wangyeee/paparazzi-hardware/controller/lisa_lc/v1.1/prod/readme.txt

Note:
Only the gerber files are tested. The pick & place files are not. Use at your own risk.
