wangyeee/paparazzi-hardware/controller/lisa_lc/v1.1/IMU.pdf

A

A

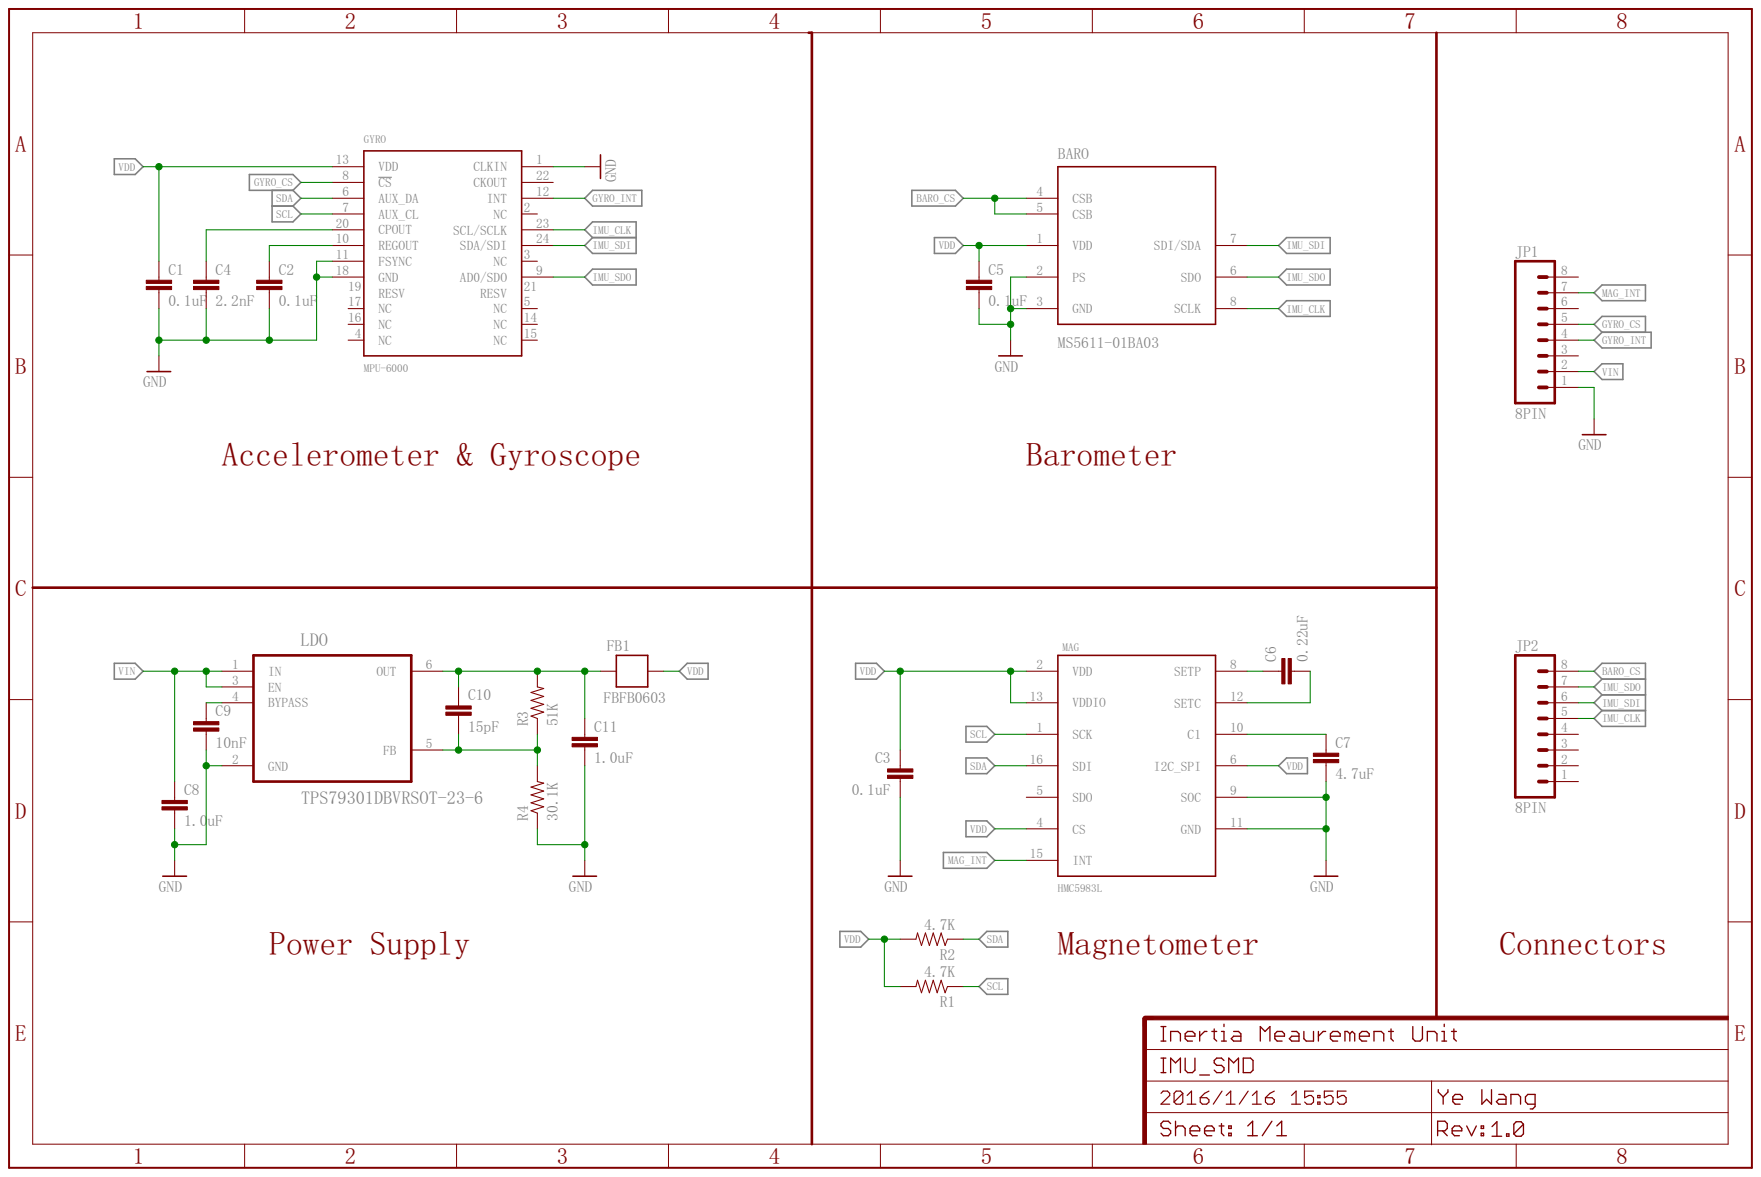
[picture p1: page 1]

GYRO | BARO | JP1

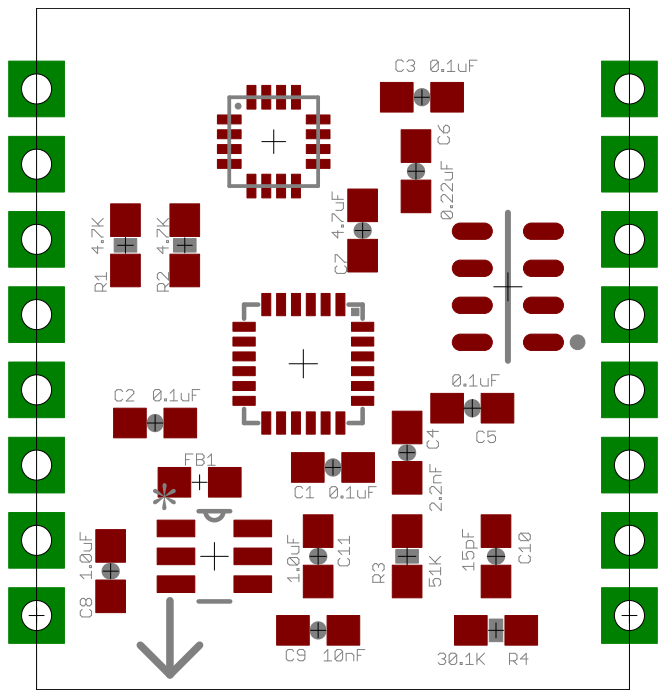
[picture p2: page 2]
