wangyeee/paparazzi-hardware/controller/lisa_lc/v1.1/AutoPilot.pdf

10K

10uF

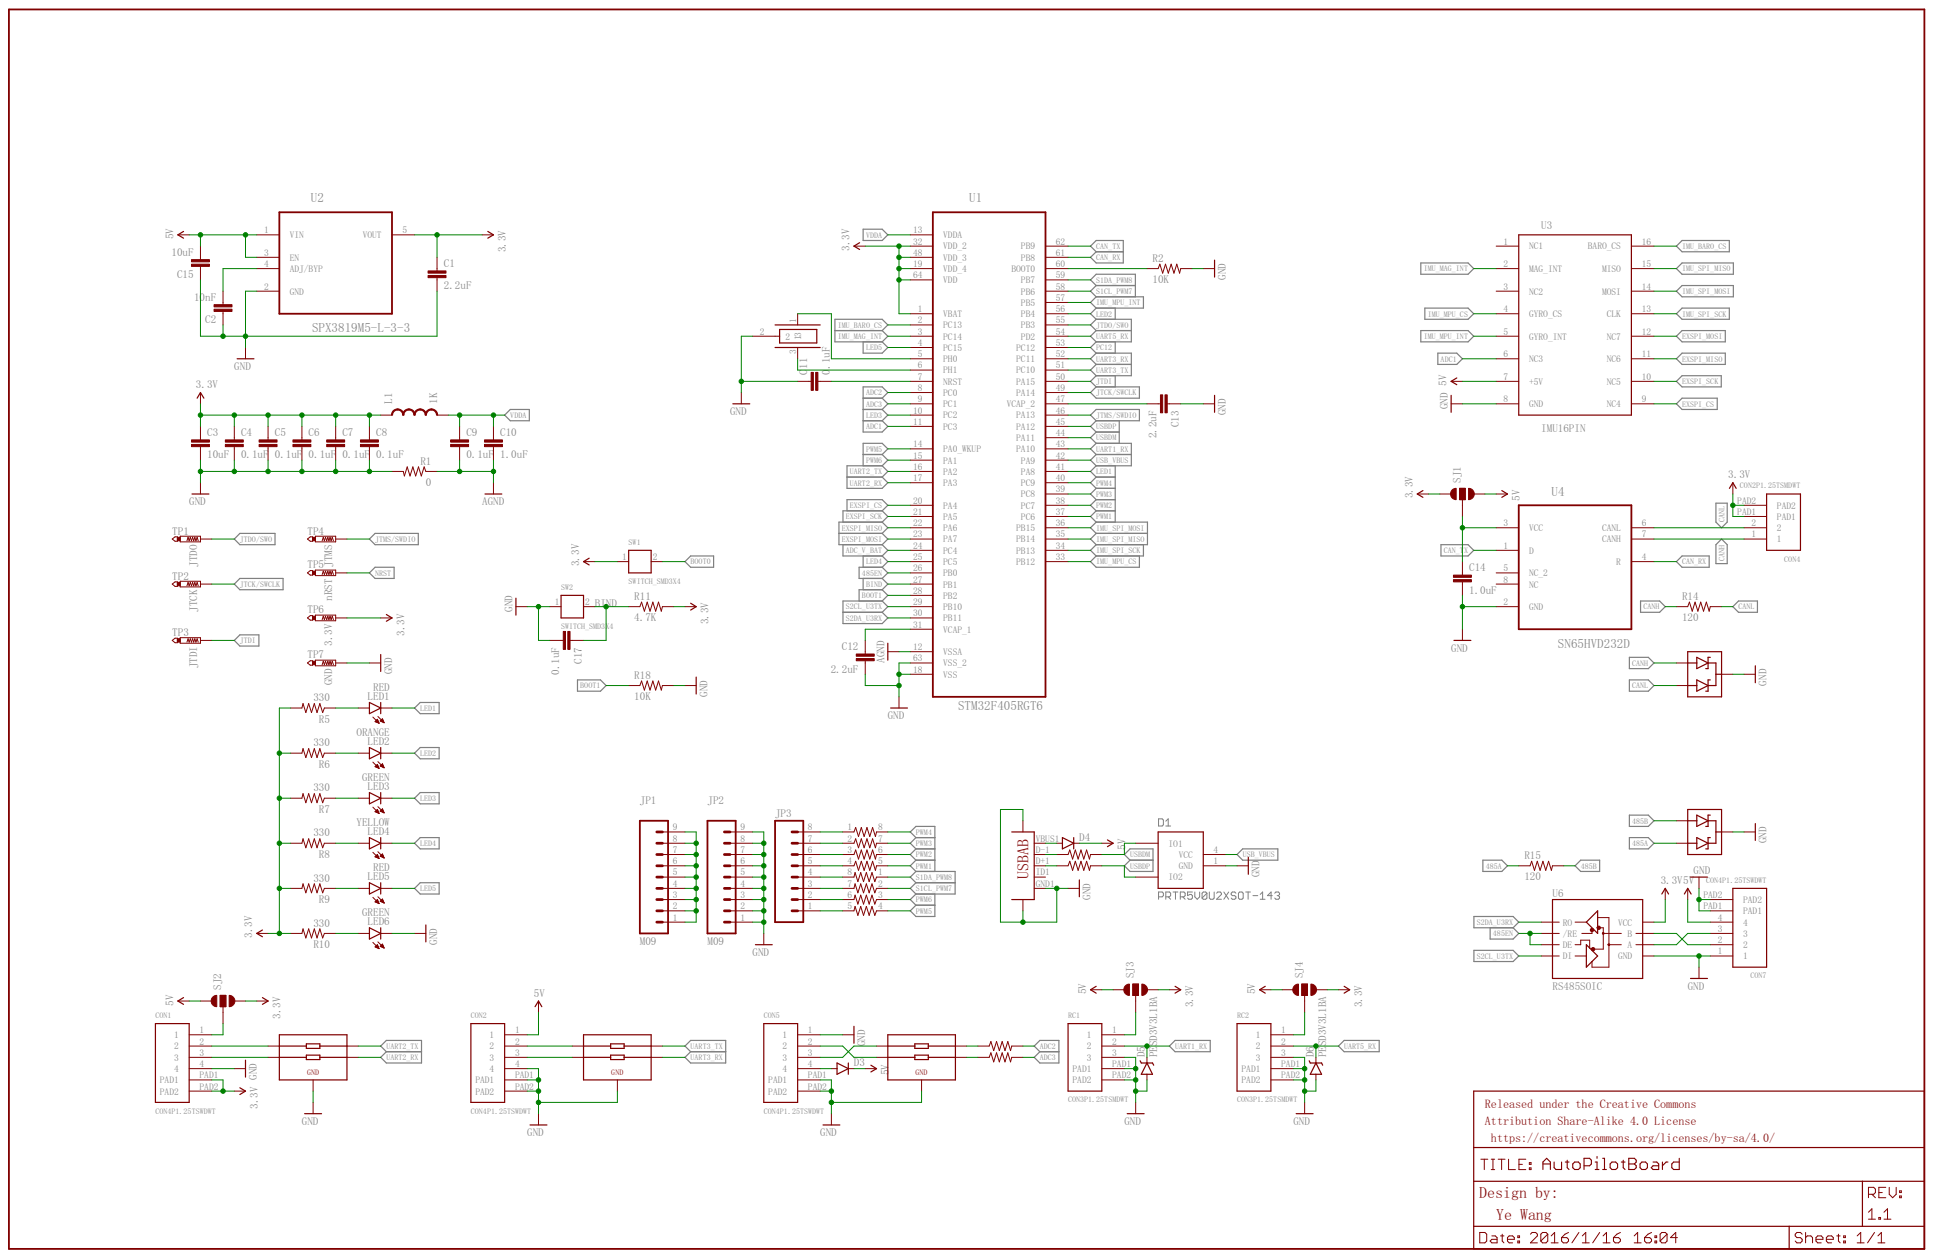
[picture p3: page 1]

Attribution Share-Alike 4.0 License
https://creativecommons.org/licenses/by-sa/4.0/

*

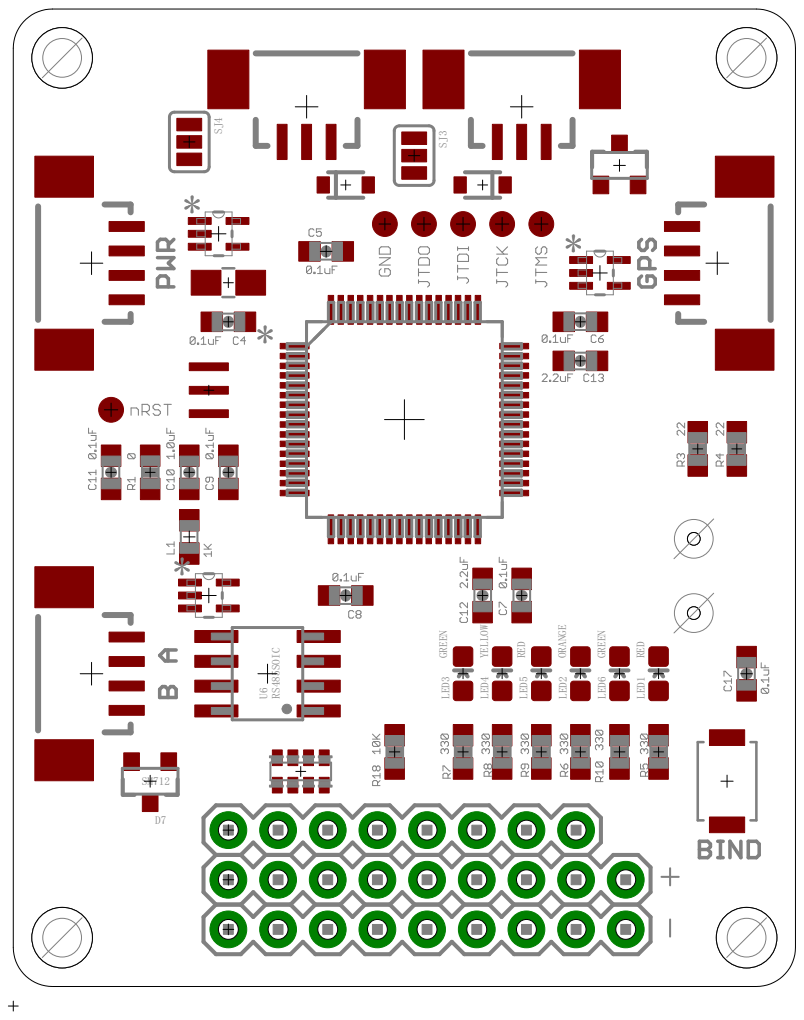
[picture p4: page 2]

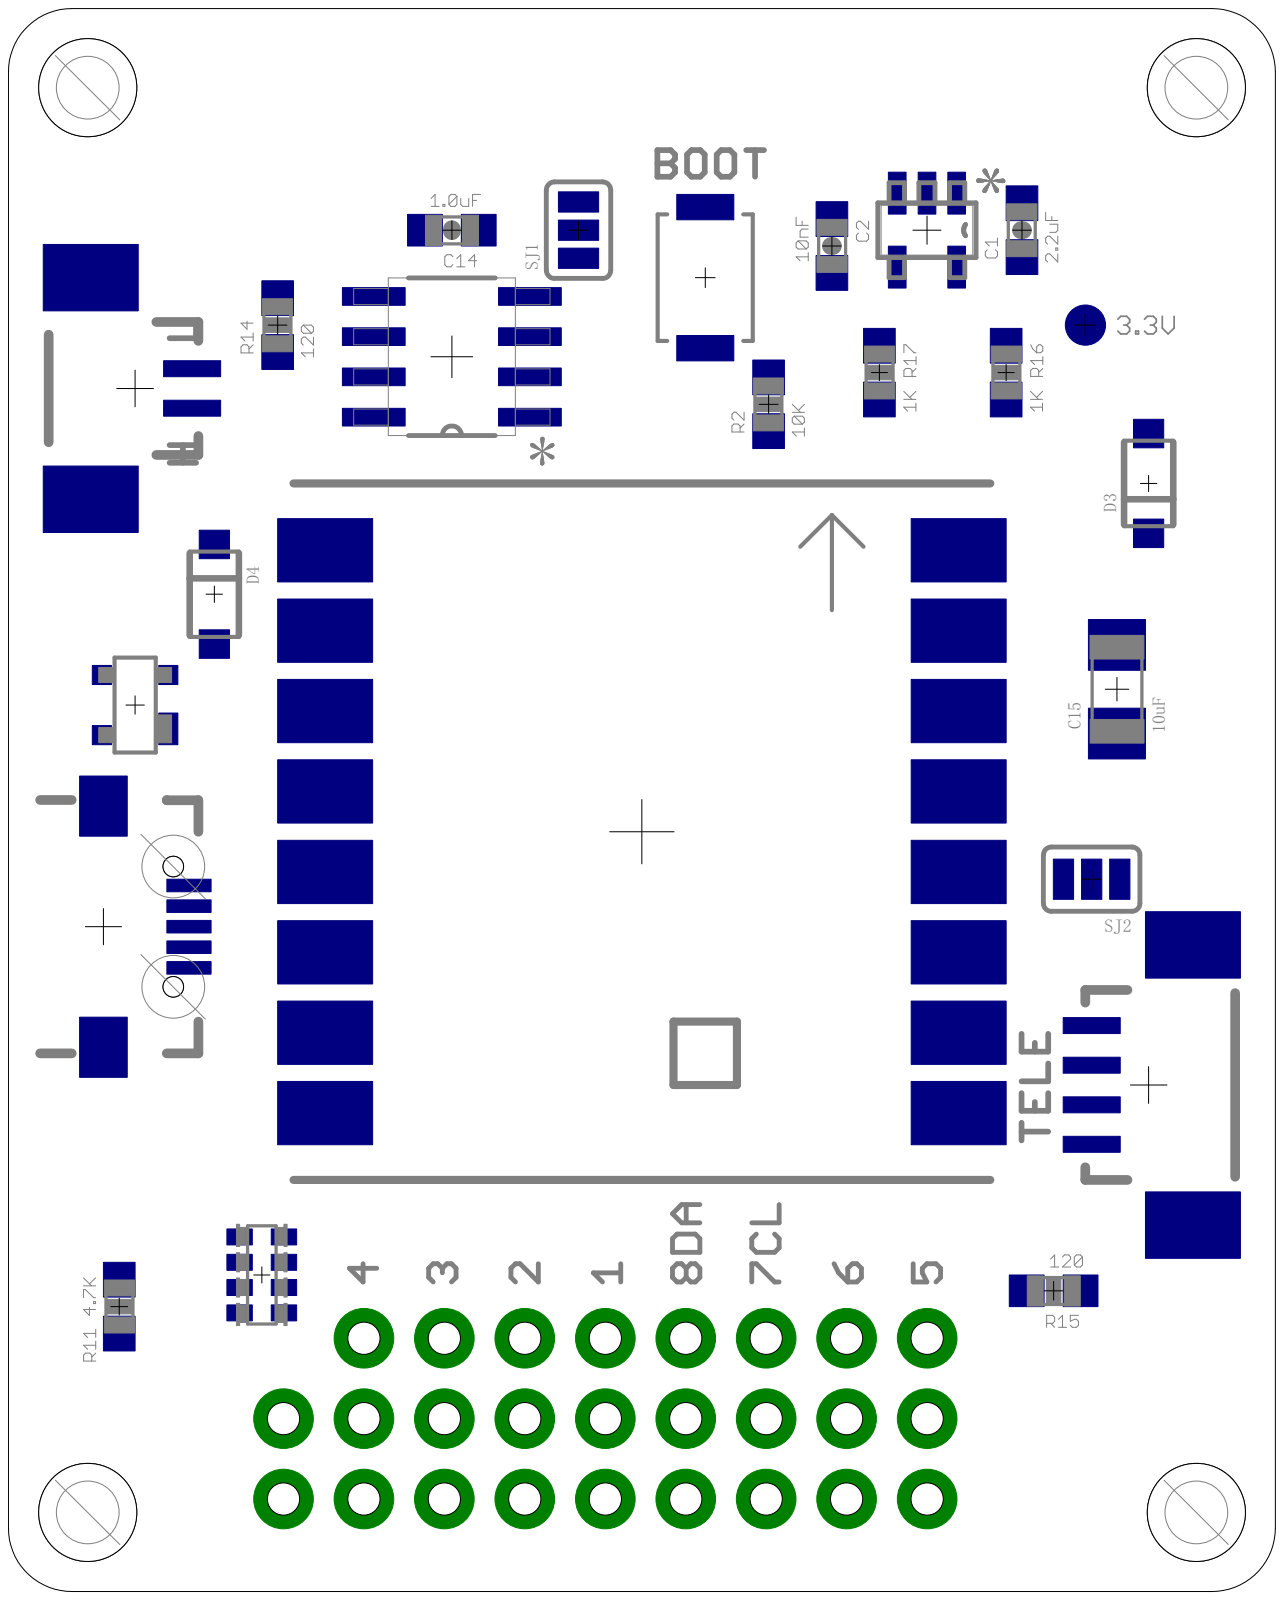
[picture p5: page 3]
