wangyeee/paparazzi-hardware/controller/lisa_lc/v1.1/AutoPilotBoard.brd

## EAGLE design controller/lisa_lc/v1.1/AutoPilotBoard.brd (2016-01-18)

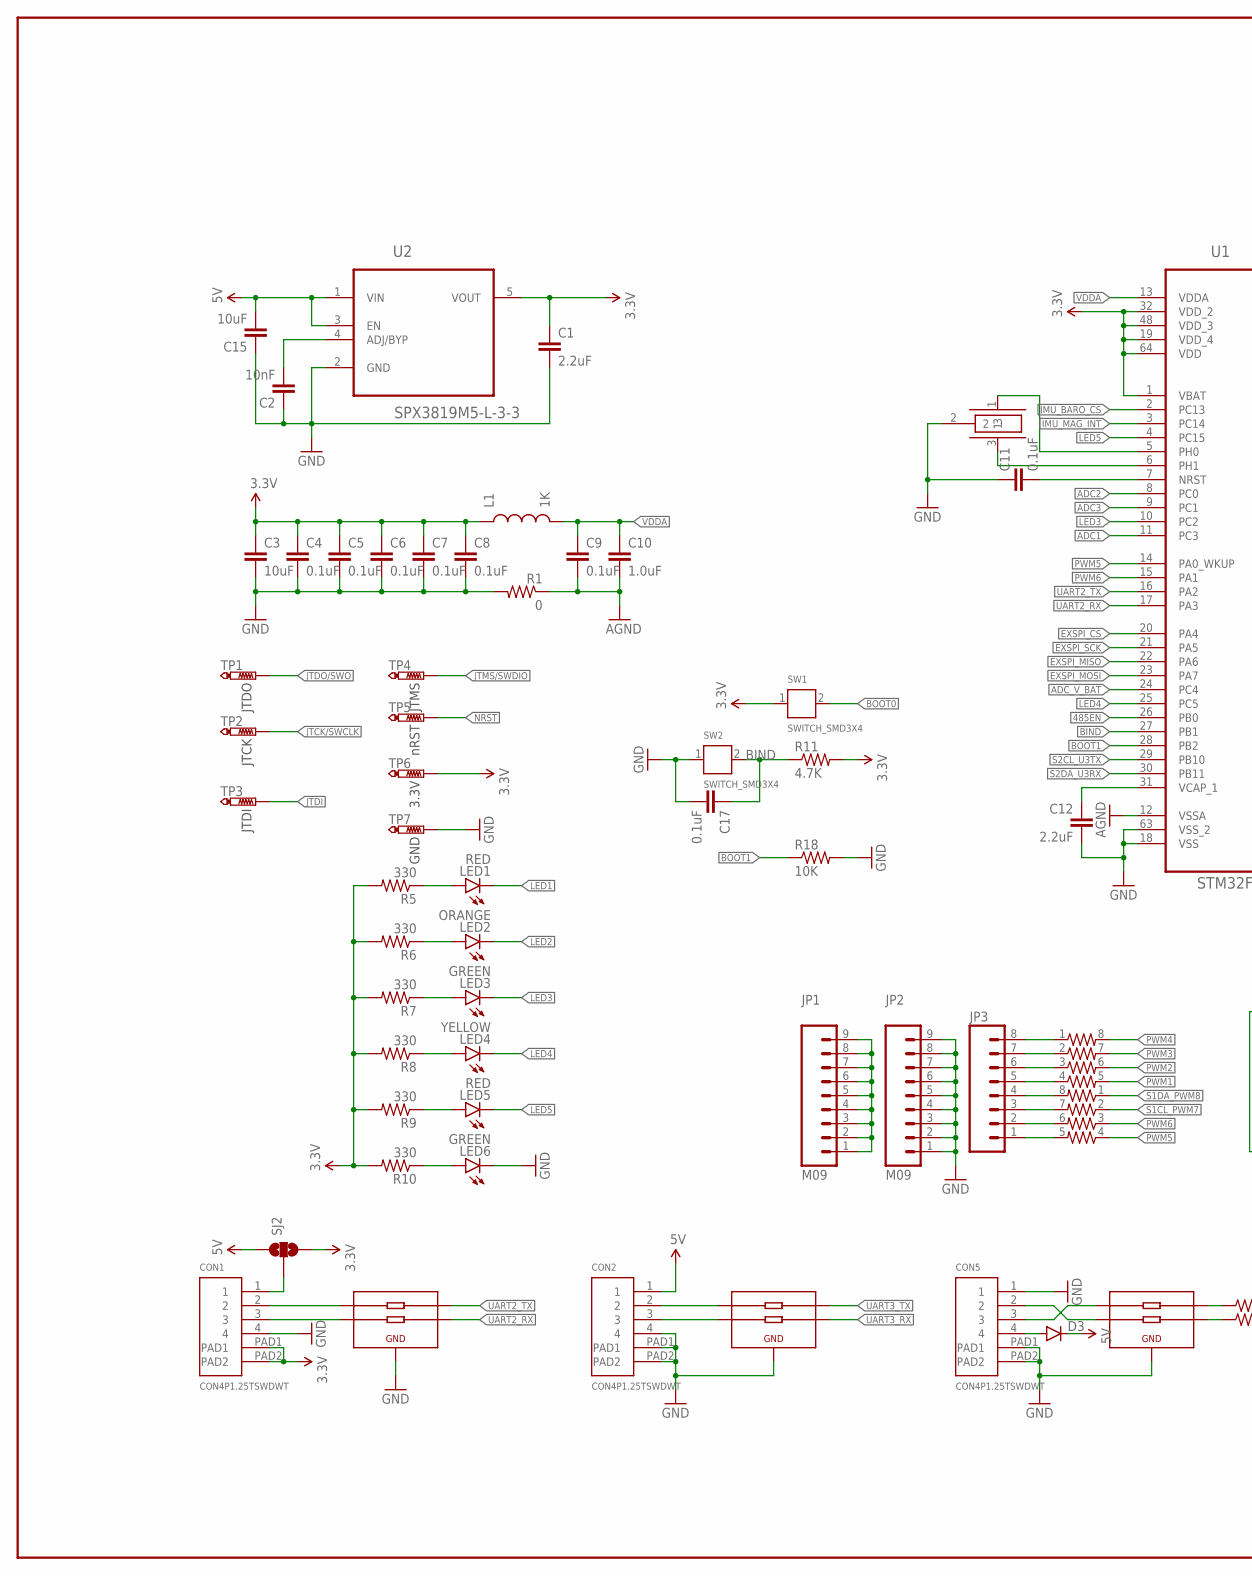
[picture p6: schematic AutoPilotBoard.sch, part in row 1, column 1]

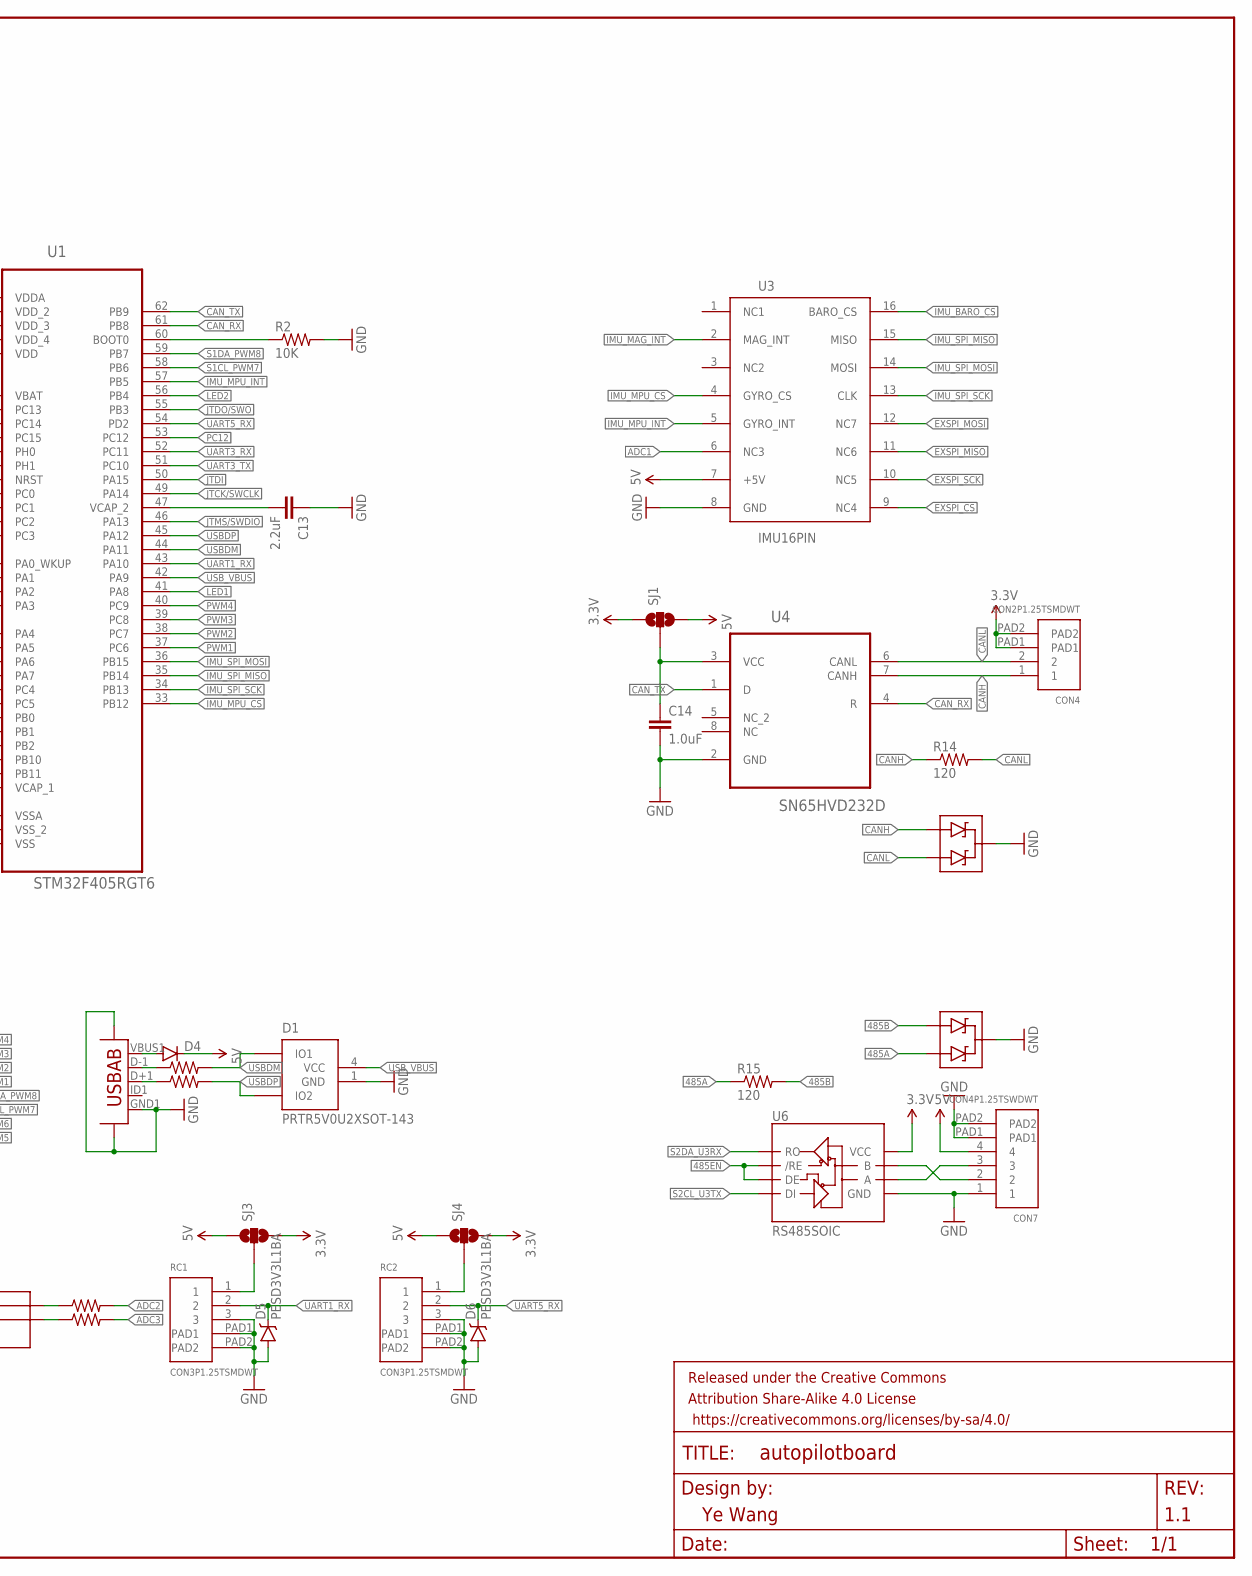
[picture p7: schematic AutoPilotBoard.sch, part in row 1, column 2]

Parts:
C1, C12, C13: 2.2uF; 0603-CAP
C2: 10nF; 0603-CAP
C3: 10uF; 0805-CAP
C4, C5, C6, C7, C8, C9, C11, C17: 0.1uF; 0603-CAP
C10, C14: 1.0uF; 0603-CAP
C15: 10uF; 1206
CON1, CON2, CON5, CON7: CON4P1.25TSWDWT; 1.25T4P
CON4: CON2P1.25TSMDWT; 1.25T2P
D1: PRTR5V0U2XSOT-143; SOT-143B
D2: PESD1CAN; SOT23-3
D3, D4: DIODESOD123; SOD-123
D5, D6: PESD3V3L1BA; SOD-323
D7: SM712; SOT23-3
FIL1, FIL2, FIL3: IP4256CZ5-W; SOT65P210X110-5N
FRAME1: FRAME-LEDGERNO_PKG; DUMMY
JP1, JP2: M09; 1X09
JP3: M08RND; 1X08_ROUND
L1: 1K; 0603
LED1, LED5: RED; LED-0603
LED2: ORANGE; LED-0603
LED3, LED6: GREEN; LED-0603
LED4: YELLOW; LED-0603
R1: 0; 0603-RES
R2, R18: 10K; 0603-RES
R3, R4: 22; 0603-RES
R5, R6, R7, R8, R9, R10: 330; 0603-RES
R11: 4.7K; 0603-RES
R12, R13: 1K; 0603-ARV
R14, R15: 120; 0603-RES
R16, R17: 1K; 0603-RES
RC1, RC2: CON3P1.25TSMDWT; 1.25T3P
SJ1, SJ2, SJ3, SJ4: SOLDERJUMPER_2WAYS; SJ_3
SW1, SW2: SWITCH_SMD3X4; SWITCH3X4_SMD
TP1, TP2, TP3, TP4, TP5, TP6, TP7: PTR1B1,27; B1,27
U1: STM32F405RGT6; QFP50P1200X1200X160-64N
U2: SPX3819M5-L-3-3; SOT95P280X145-5N
U3: IMU16PIN; SMD23X23
U4: SN65HVD232D; SOIC127P600X175-8N
U5: USB-ABCONN-11794; USB-AB-MICRO-SMD_V03
U6: RS485SOIC; SO08
X1: CSTCE8M00G52-R0; CSTCE_M_G

Connections:
3.3V: C1.1, C3.P$1 (1), C4.1, C5.1, C6.1, C7.1, C8.1, CON1.PAD1, CON1.PAD2, CON4.PAD1, CON4.PAD2, L1.1, R5.2, R6.2, R7.2, R8.2, R9.2, R10.2, R11.2, SJ1.1, SJ2.3, SJ3.3, SJ4.3, SW1.1, TP6.TP, U1.1 (VBAT), U1.19 (VDD_4), U1.32 (VDD_2), U1.48 (VDD_3), U1.64 (VDD), U2.5 (VOUT), U6.8 (VCC)
5V: C15.2, CON2.1, CON7.4, D3.C, D4.C, SJ1.3, SJ2.1, SJ3.1, SJ4.1, U2.1 (VIN), U2.3 (EN), U3.7 (+5V)
485A: CON7.3, D7.2 (A2), R15.1, U6.6 (A)
485B: CON7.2, D7.1 (A1), R15.2, U6.7 (B)
485EN: U1.26 (PB0), U6.2 (/RE), U6.3 (DE)
ADC1: U1.11 (PC3), U3.6 (NC3)
ADC2: R16.2, U1.8 (PC0)
ADC3: R17.2, U1.9 (PC1)
ADC_V_BAT: U1.24 (PC4)
AGND: C9.2, C10.2, R1.1, U1.12 (VSSA)
BIND: C17.1, R11.1, SW2.2, U1.27 (PB1)
BOOT0: R2.1, SW1.2, U1.60 (BOOT0)
BOOT1: R18.1, U1.28 (PB2)
CANH: CON4.1, D2.1 (A1), R14.1, U4.7 (CANH)
CANL: CON4.2, D2.2 (A2), R14.2, U4.6 (CANL)
CAN_RX: U1.61 (PB8), U4.4 (R)
CAN_TX: U1.62 (PB9), U4.1 (D)
EXSPI_CS: U1.20 (PA4), U3.9 (NC4)
EXSPI_MISO: U1.22 (PA6), U3.11 (NC6)
EXSPI_MOSI: U1.23 (PA7), U3.12 (NC7)
EXSPI_SCK: U1.21 (PA5), U3.10 (NC5)
GND: C1.2, C2.1, C3.P$2 (2), C4.2, C5.2, C6.2, C7.2, C8.2, C11.1, C12.2, C13.1, C14.2, C15.1, C17.2, CON1.4, CON2.4, CON2.PAD1, CON2.PAD2, CON5.1, CON5.PAD1, CON5.PAD2, CON7.1, CON7.PAD1, CON7.PAD2, D1.1 (GND), D2.3 (C), D5.A, D6.A, D7.3 (C), FIL1.2, FIL2.2, FIL3.2, JP2.1, JP2.2, JP2.3, JP2.4, JP2.5, JP2.6, JP2.7, JP2.8, JP2.9, LED6.C, R1.2, R2.2, R18.2, RC1.3, RC1.PAD1, RC1.PAD2, RC2.3, RC2.PAD1, RC2.PAD2, SW2.1, TP7.TP, U1.18 (VSS), U1.63 (VSS_2), U2.2 (GND), U3.8 (GND), U4.2 (GND), U5.CON1 (SHL1), U5.CON2 (SHL2), U5.GND1 (GND), U6.5 (GND), X1.2
IMU_BARO_CS: U1.2 (PC13), U3.16 (BARO_CS)
IMU_MAG_INT: U1.3 (PC14), U3.2 (MAG_INT)
IMU_MPU_CS: U1.33 (PB12), U3.4 (GYRO_CS)
IMU_MPU_INT: U1.57 (PB5), U3.5 (GYRO_INT)
IMU_SPI_MISO: U1.35 (PB14), U3.15 (MISO)
IMU_SPI_MOSI: U1.36 (PB15), U3.14 (MOSI)
IMU_SPI_SCK: U1.34 (PB13), U3.13 (CLK)
JTCK/SWCLK: TP2.TP, U1.49 (PA14)
JTDI: TP3.TP, U1.50 (PA15)
JTDO/SWO: TP1.TP, U1.55 (PB3)
JTMS/SWDIO: TP4.TP, U1.46 (PA13)
LED1: LED1.C, U1.41 (PA8)
LED2: LED2.C, U1.56 (PB4)
LED3: LED3.C, U1.10 (PC2)
LED4: LED4.C, U1.25 (PC5)
LED5: LED5.C, U1.4 (PC15)
unnamed: C14.1, SJ1.2, U4.3 (VCC)
unnamed: U1.6 (PH1), X1.3
unnamed: C2.2, U2.4 (ADJ/BYP)
unnamed: U1.5 (PH0), X1.1
unnamed: C12.1, U1.31 (VCAP_1)
unnamed: C13.2, U1.47 (VCAP_2)
unnamed: R3.1, U5.D-1 (D-)
unnamed: R4.1, U5.D+1 (D+)
unnamed: LED1.A, R5.1
unnamed: LED3.A, R7.1
unnamed: LED4.A, R8.1
unnamed: LED5.A, R9.1
unnamed: LED2.A, R6.1
unnamed: CON5.3, FIL1.1
unnamed: RC1.1, SJ3.2
unnamed: CON5.2, FIL1.3
unnamed: JP3.5, R12.4 (1)
unnamed: JP3.6, R12.3 (1)
unnamed: JP3.7, R12.2 (1)
unnamed: JP3.8, R12.1
unnamed: JP3.4, R13.8 (2)
unnamed: JP3.3, R13.7 (2)
unnamed: JP3.2, R13.6 (2)
unnamed: LED6.A, R10.1
unnamed: JP3.1, R13.5 (2)
unnamed: FIL1.5, R16.1
unnamed: FIL1.4, R17.1
unnamed: CON1.2, FIL2.1
unnamed: CON1.3, FIL2.3
unnamed: CON2.3, FIL3.4
unnamed: CON2.2, FIL3.5
unnamed: CON5.4, D3.A
unnamed: CON1.1, SJ2.2
unnamed: RC2.1, SJ4.2
NRST: C11.2, TP5.TP, U1.7 (NRST)
PC12: U1.53 (PC12)
PWM1: R12.5 (2), U1.37 (PC6)
PWM2: R12.6 (2), U1.38 (PC7)
PWM3: R12.7 (2), U1.39 (PC8)
PWM4: R12.8 (2), U1.40 (PC9)
PWM5: R13.4 (1), U1.14 (PA0_WKUP)
PWM6: R13.3 (1), U1.15 (PA1)
S1CL_PWM7: R13.2 (1), U1.58 (PB6)
S1DA_PWM8: R13.1, U1.59 (PB7)
S2CL_U3TX: U1.29 (PB10), U6.4 (DI)
S2DA_U3RX: U1.30 (PB11), U6.1 (RO)
SRV_COM: JP1.1, JP1.2, JP1.3, JP1.4, JP1.5, JP1.6, JP1.7, JP1.8, JP1.9
UART1_RX: D5.C, RC1.2, U1.43 (PA10)
UART2_RX: FIL2.4, U1.17 (PA3)
UART2_TX: FIL2.5, U1.16 (PA2)
UART3_RX: FIL3.3, U1.52 (PC11)
UART3_TX: FIL3.1, U1.51 (PC10)
UART5_RX: D6.C, RC2.2, U1.54 (PD2)
USBDM: D1.2 (IO1), R3.2, U1.44 (PA11)
USBDP: D1.3 (IO2), R4.2, U1.45 (PA12)
USB_VBUS: D1.4 (VCC), D4.A, U1.42 (PA9), U5.VBUS1 (VBUS)
VDDA: C9.1, C10.1, L1.2, U1.13 (VDDA)

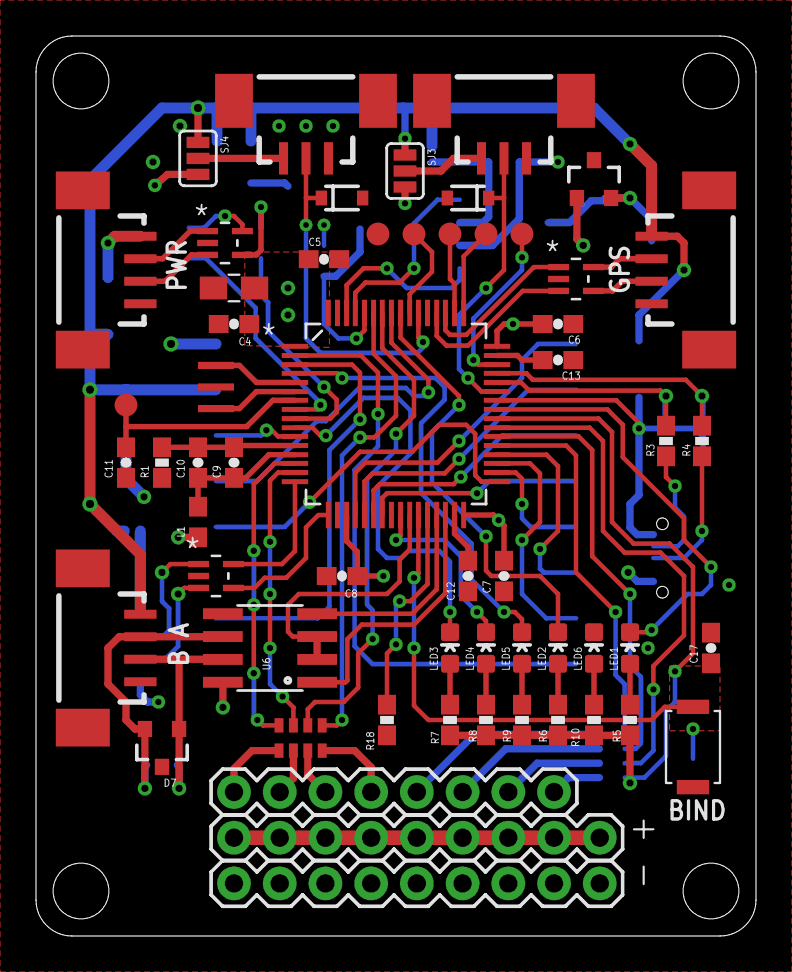
[picture p8: board AutoPilotBoard.brd from above]

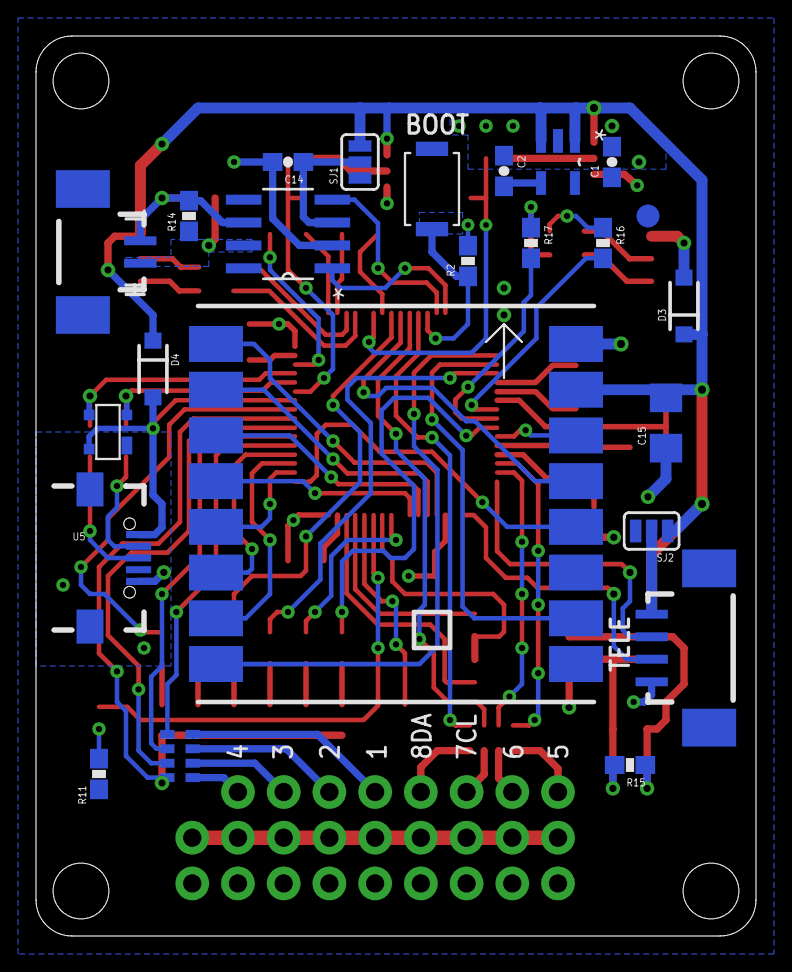
[picture p9: board AutoPilotBoard.brd from below]

Board: 2 copper layers, 40.0 x 50.0 mm, 82 parts (24 on the bottom side), 93 nets.
