wangyeee/paparazzi-hardware/controller/lisa_lc/v1.1/IMU_SMD.brd

## EAGLE design controller/lisa_lc/v1.1/IMU_SMD.brd (2016-01-18)

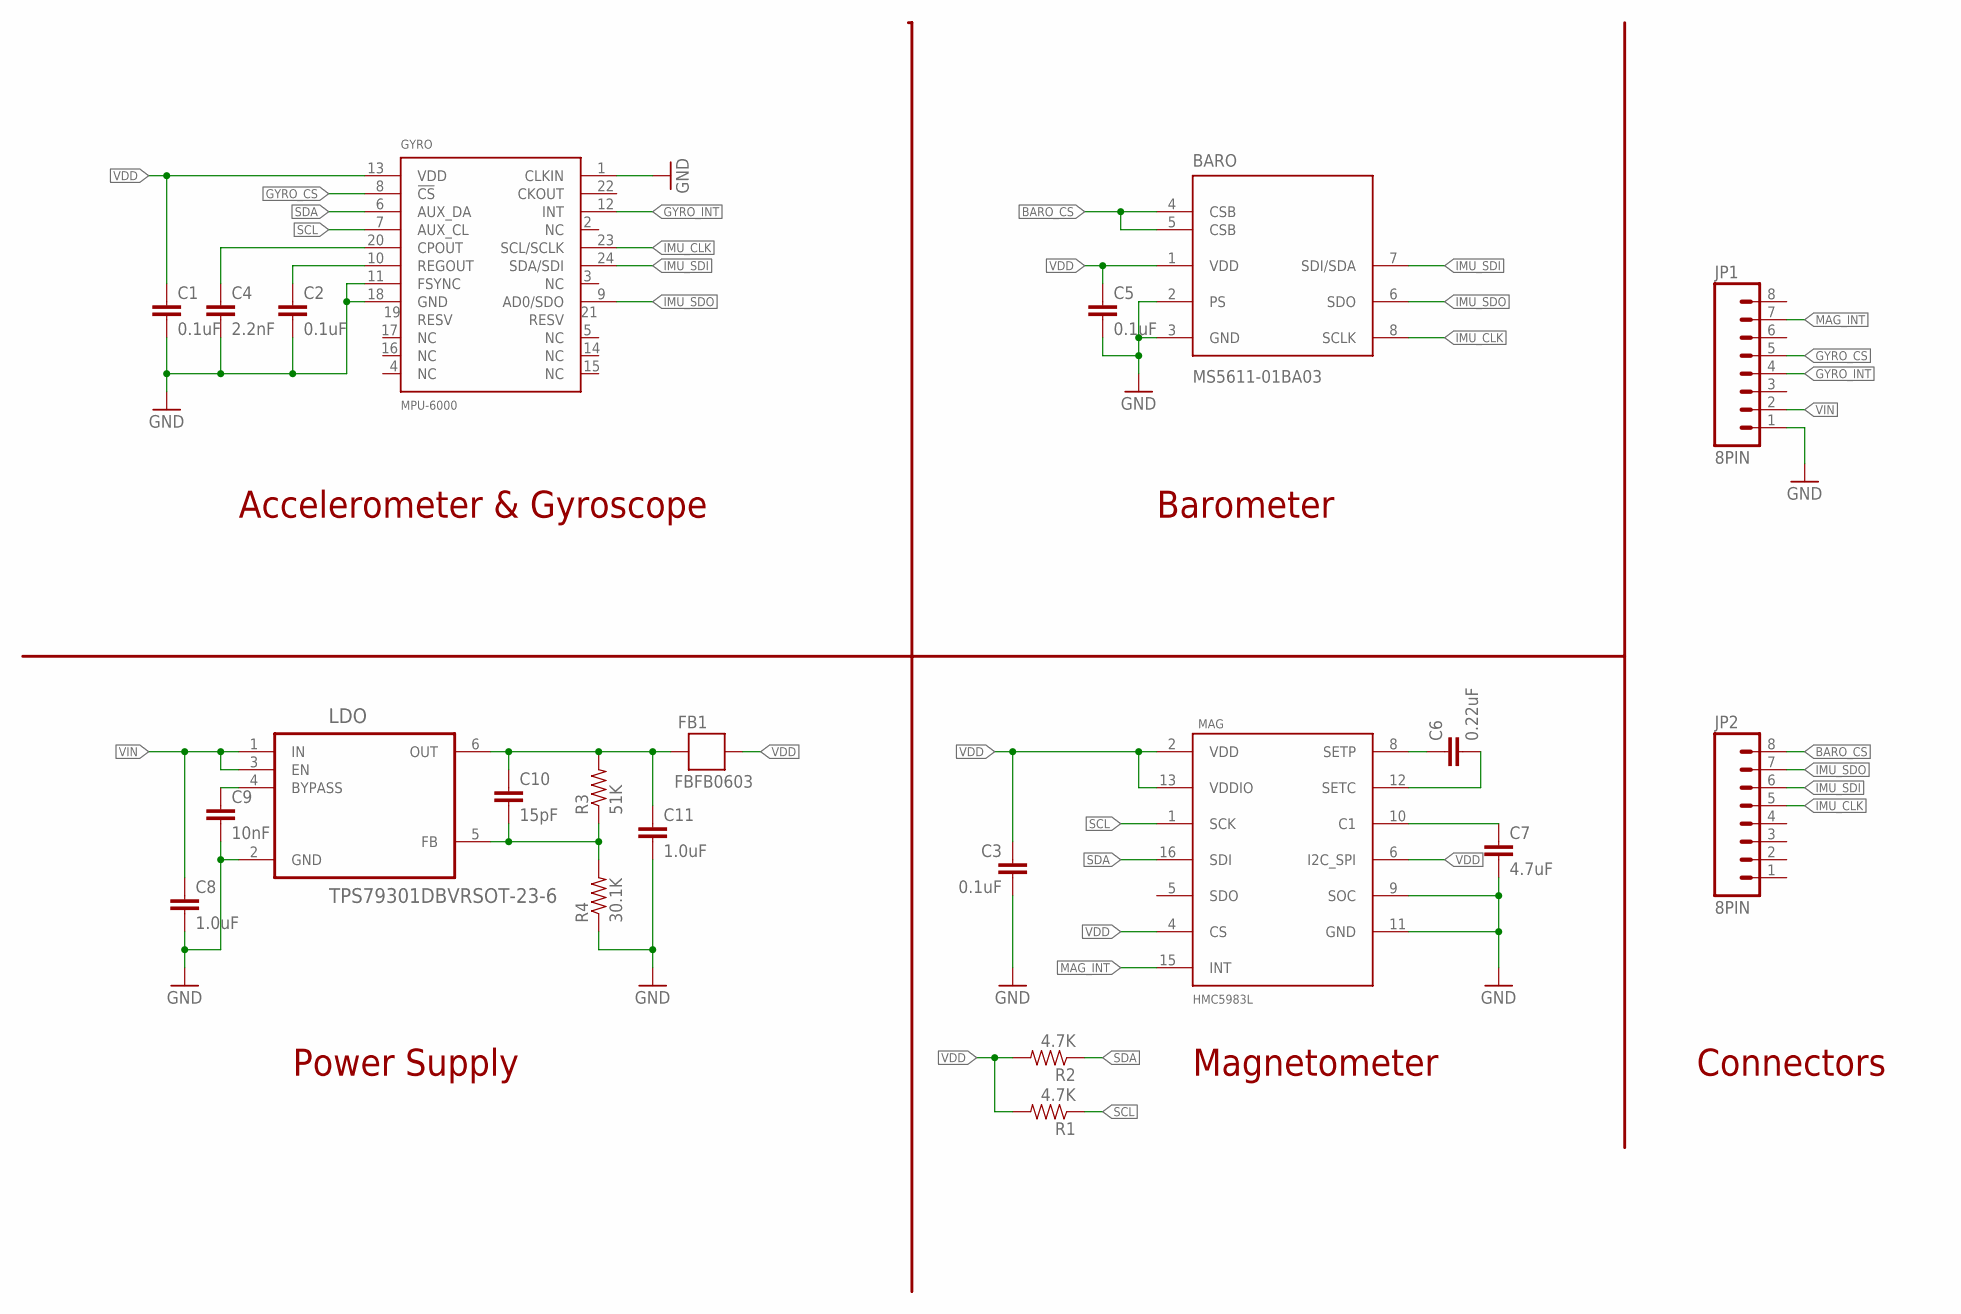
[picture p10: schematic IMU_SMD.sch]

Parts:
BARO: MS5611-01BA03; SON125P300X500X100-8N
C1, C2, C3, C5: 0.1uF; 0603-CAP
C4: 2.2nF; 0603-CAP
C6: 0.22uF; 0603-CAP
C7: 4.7uF; 0603-CAP
C8, C11: 1.0uF; 0603-CAP
C9: 10nF; 0603-CAP
C10: 15pF; 0603-CAP
FB1: FBFB0603; 0603
GYRO: MPU-6000; QFN24-NO-PAD
JP1, JP2: 8PIN; 1X08_SQE_NO_SILK
LDO: TPS79301DBVRSOT-23-6; SOT95P280X145-6N
MAG: HMC5983L; LPCC16
R1, R2: 4.7K; 0603-RES
R3: 51K; 0603-RES
R4: 30.1K; 0603-RES

Connections:
BARO_CS: BARO.4 (CSB), BARO.5 (CSB), JP2.8
GND: BARO.2 (PS), BARO.3 (GND), C1.2, C2.2, C3.2, C4.2, C5.2, C7.2, C8.2, C9.2, C11.2, GYRO.1 (CLKIN), GYRO.11 (FSYNC), GYRO.18 (GND), JP1.1, LDO.2 (GND), MAG.9 (SOC), MAG.11 (GND), R4.1
GYRO_CS: GYRO.8 (!CS), JP1.5
GYRO_INT: GYRO.12 (INT), JP1.4
IMU_CLK: BARO.8 (SCLK), GYRO.23 (SCL/SCLK), JP2.5
IMU_SDI: BARO.7 (SDI/SDA), GYRO.24 (SDA/SDI), JP2.6
IMU_SDO: BARO.6 (SDO), GYRO.9 (AD0/SDO), JP2.7
MAG_INT: JP1.7, MAG.15 (INT)
unnamed: C9.1, LDO.4 (BYPASS)
unnamed: C10.1, C11.1, FB1.2, LDO.6 (OUT), R3.2
unnamed: C2.1, GYRO.10 (REGOUT)
unnamed: C4.1, GYRO.20 (CPOUT)
unnamed: C10.2, LDO.5 (FB), R3.1, R4.2
unnamed: C6.1, MAG.8 (SETP)
unnamed: C6.2, MAG.12 (SETC)
unnamed: C7.1, MAG.10 (C1)
SCL: GYRO.7 (AUX_CL), MAG.1 (SCK), R1.1
SDA: GYRO.6 (AUX_DA), MAG.16 (SDI), R2.1
VDD: BARO.1 (VDD), C1.1, C3.1, C5.1, FB1.1, GYRO.13 (VDD), MAG.2 (VDD), MAG.4 (CS), MAG.6 (I2C_SPI), MAG.13 (VDDIO), R1.2, R2.2
VIN: C8.1, JP1.2, LDO.1 (IN), LDO.3 (EN)

Notes on the sheet:
Accelerometer & Gyroscope
Barometer
Power Supply
Magnetometer
Connectors

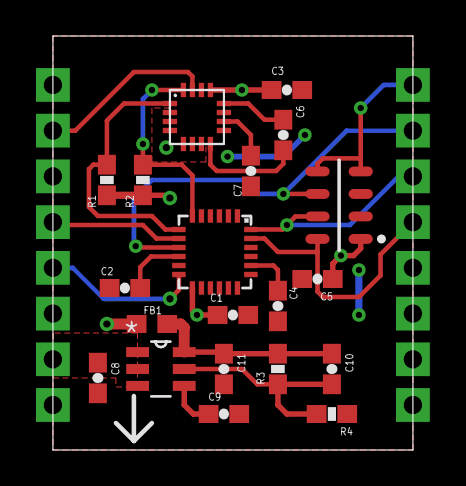
[picture p11: board IMU_SMD.brd from above]

Board: 2 copper layers, 20.0 x 23.0 mm, 22 parts (0 on the bottom side), 20 nets.
